EzeG99/IHP130nm---Pipeline-ADC/report/plotsBKP/WAVE_SS_sch.jpg

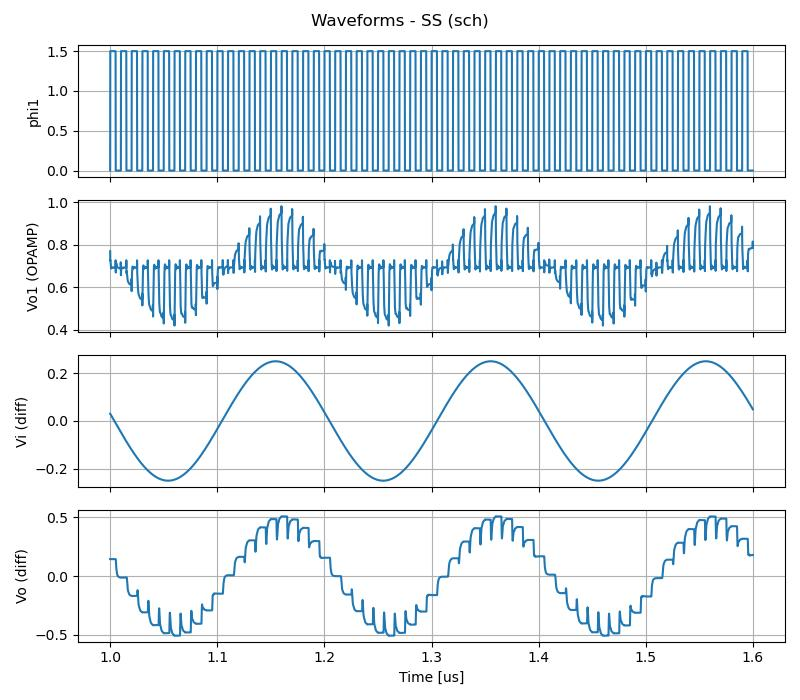
report/plotsBKP/WAVE_SS_sch.jpg
