EzeG99/IHP130nm---Pipeline-ADC/report/main.tex

\documentclass[11pt,a4paper]{article}
% ===============================
% Packages
% ===============================
\usepackage[margin=2.5cm]{geometry}
\usepackage{graphicx}
\usepackage{caption}
\usepackage{amsmath}
\usepackage{svg}
\usepackage{siunitx}
\usepackage{booktabs}
\usepackage{float}
\usepackage{cite}
\usepackage{hyperref}
\usepackage{amsmath}
\usepackage{amssymb}
\usepackage{subcaption}
\usepackage{tikz}
\usepackage{tikz-cd}
\usepackage{float}
\usepackage{multicol}
\usepackage{threeparttable}
\usepackage{threeparttable}
\usepackage{cite}

% ===============================
% Title
% ===============================
\title{Design Methodology of a Multiplying DAC for a 10-bit, 100~MS/s Pipeline ADC in IHP 130~nm CMOS}
\author{Giorgis Ezequiel}
\date{\today}

\begin{document}

\begin{titlepage}
    \centering
    \vspace*{\fill}

    {\Huge Design Methodology of a Multiplying DAC for a 10-bit, 100~MS/s Pipeline ADC in IHP 130~nm CMOS \par}
    \vspace{1.5cm}

    {\huge Giorgis Ezequiel \par}
    \vspace{0.5cm}

    {\Large \today \par}

    \vspace*{\fill}
\end{titlepage}
\tableofcontents
\newpage

% =========================================================
\begin{abstract}
This work presents the complete design flow of a MDAC stage for a 10 bits, 100 M/s
ADC implemented in IHP 130~nm CMOS usign open source tools. 
The target converter operates at 1.5V, 100~MS/s with 10-bit resolution and 1V$_{pp}$ 
differential output swing, with robust operation across process, voltage, and temperature (PVT) corners.
Starting from system-level requirements, we derive 
quantitative MDAC constraints on thermal noise, closed-loop settling, static gain 
accuracy, slew-rate, unity-gain bandwidth (UGBW), and phase margin for a given capacitive load.
\end{abstract}

\section{Introduction}
Pipeline Analog-to-Digital Converters (ADCs) are in modern high-speed, medium-to-high resolution 
applications due to their favorable trade-off between sampling rate, power efficiency, and achievable accuracy.

\begin{figure}[H]
  \begin{center}
    
  \end{center}
  \caption{Block diagram of a ADC pipeline}\label{fig:block}
\end{figure}

As described in \cite{razavi_data_converters}, this type of ADCs achieve high throughput by distributing quantization across 
multiple stages as shown in Fig. \ref{fig:block}, each composed of a sub-ADC, sub-DAC, residue amplifier, and 
sample-and-hold function. The MDAC (Fig. \ref{fig:mdac}) is the central block in each stage because 
it both reconstructs the coarse quantization level and amplifies the residue for the 
next stage. For an ideal 1.5-bit/stage implementation, the residue transfer is
\begin{equation}
V_{res}=2V_{in}-D\cdot V_{ref},
\end{equation}
where $D\in\{-1,0,+1\}$ is the digital decision and the gain factor of 2 is realized by capacitor ratio and closed-loop OTA action.

\begin{figure}[H]
  \begin{center}
    
  \end{center}
  \caption{Flip around MDAC}\label{fig:mdac}
\end{figure}

\section{System-Level Specifications and Derived MDAC Targets}
\subsection{ADC specifications}
The intended converter parameters are summarized in Table~\ref{tab:spec}, while operating conditions are outlined in Table \ref{tab:conditions}.

\begin{table}[h]
\centering
\caption{System specifications}
\label{tab:spec}
\begin{tabular}{lc}
\hline
\textbf{Parameter} & \textbf{Target} \\
\hline
Architecture & Pipeline \\
Structure & Fully differential \\
Resolution & 10 bits \\
Sampling rate $f_s$ & 100~MS/s \\
Output swing & 1V$_{pp}$ differential \\
Technology & IHP 130~nm CMOS \\
\hline
\end{tabular}
\end{table}

\begin{table}[h]
\centering
\caption{System operating conditions}
\label{tab:conditions}
\begin{tabular}{lc}
\hline
\textbf{Condition} & \textbf{Value} \\
\hline
Load capacitance $C_L$ & 1.25~pF \\
Supply voltage $V_{DD}$ & 1.5~V \\
Common-mode level $V_{CM}$ & 0.7~V \\
Operating temperature  & $0^\circ C$ to  $125^\circ C$\\
\hline
\end{tabular}
\end{table}
\subsection{Derived amplifier requirements}
\subsubsection{Gain}
For a closed-loop residue gain of 2, finite OTA gain $A_0$ introduces fractional gain error roughly
\begin{equation}
\varepsilon_g\approx\frac{1}{\beta A_0},
\end{equation}
where $\beta$ is the feedback factor (typically near 0.5 in a gain-of-2 MDAC). Requiring residue gain error to be significantly below 0.5 LSB referred to full scale leads to
\begin{equation}
\varepsilon_g\lesssim\frac{1}{2^{N+1}} \quad\therefore\quad A_0\gtrsim\frac{2^{N+1}}{\beta}.
\end{equation}
For $N=10$ and $\beta=0.5$, this implies $A_0\gtrsim 4096$ ($\approx72$~dB). With digital calibration and redundancy, relaxed targets are possible; nevertheless 70--75~dB open-loop gain is a robust design objective.

\subsubsection{Unity-Gain Bandwidth and Phase Margin}
At 100~MS/s, the clock period is 10~ns. With two non-overlapping phases, available settling time in amplification phase is approximately
\begin{equation}
T_{\phi2,eff}\approx 4\text{--}5\;\text{ns}
\end{equation}
after subtracting switch dead-time and comparator latching overhead.

For first-order settling,
\begin{equation}
\left|\varepsilon_{dyn}\right|\approx e^{-t/\tau},\qquad \tau\approx\frac{1}{2\pi\beta\,\text{UGBW}}.
\end{equation}
Imposing $\varepsilon_{dyn}<1/2^{N+1}$ at $t=T_{\phi2,eff}$ yields
\begin{equation}
\text{UGBW}\gtrsim \frac{\ln(2^{N+1})}{2\pi\beta T_{\phi2,eff}}.
\end{equation}
For $N=10$, $\beta=0.5$, and $T_{\phi2,eff}=4.5$~ns, UGBW is around 540~MHz.

\subsubsection{Thermal Noise and Sampling Capacitor}
According to \cite{kledrowetz_mdac_2011}, the thermal noise introduced by the sampling switch is shaped by the RC network formed by the switch resistance $R$ and the sampling capacitor $C_s$, which behaves as a first-order low-pass filter with transfer function:

\begin{equation}
A(j\omega) = \frac{1}{1 + j\omega R C_s}
\end{equation}

The total sampled noise is obtained by integrating the filtered noise power spectral density over frequency:

\begin{equation}
\overline{e_n^2} = \frac{1}{2\pi} \int_{0}^{\infty} \overline{e_R^2} \cdot |A(j\omega)|^2 \, d\omega
\end{equation}

Substituting the thermal noise of the resistor:

\begin{equation}
\overline{e_R^2} = 4kTR
\end{equation}

\begin{align}
  \overline{e_n^2} &= \frac{1}{2\pi} \int_{0}^{\infty} \frac{4kTR}{1 + (\omega R C_s)^2} \, d\omega \\
\overline{e_n^2} &= \frac{1}{2\pi} \cdot \frac{4kTR}{R C_s} \cdot \left[ \arctan(\omega R C_s) \right]_{0}^{\infty} = \frac{kT}{C_s}
\end{align}

Imposing the resolution constraint:

\begin{equation}
\sigma_n \le \frac{LSB}{2}, \quad LSB = \frac{V_{FS}}{2^N} \Rightarrow C_s \ge \frac{kT}{(LSB/2)^2}
\end{equation}

In practice:

\begin{equation}
C_s \approx \alpha \cdot \frac{kT}{(LSB/2)^2}, \quad \alpha \approx 3\text{--}10
\end{equation}
\subsubsection{Requirements summary}
\begin{table}[H]
\centering
\caption{Target OTA specifications}
\label{tab:spec_OTA}
\begin{tabular}{lc}
\hline
\textbf{Parameter} & \textbf{Target} \\
\hline
Gain $A_0$ & $\ge$ 70~dB \\
Unity-Gain Bandwidth UGBW & $\ge$ 540~MHz \\
Phase Marigin PM & $\ge$ 60$^\circ$ \\
Output swing & 1~V$_{pp}$ diff. \\
ENOB @ $f_{in} \approx f_{s}/20$ & $\ge 9.5$ bits \\
ENOB @ $f_{in} \approx f_{s}/2$ & $\ge 8$ bits \\
Sampling capacitors   & $\approx 500$ fF \\
Load capacitance $C_L$ & 1.25~pF \\
Supply voltage $V_{DD}$ & 1.5~V$\pm$5\% \\
Common-mode level $V_{CM}$ & 0.7~V$\pm$5\% \\
Bias current $I_{ref}$ & 50~$\mu$A$\pm$5\% \\
Operating temperature  & $0^\circ C$ to  $125^\circ C$ \\
\hline
\end{tabular}
\end{table}

\subsection{Corners definition}
To ensure the MDAC meets gain, settling, and stability targets under realistic spread, corner-based verification is grouped into three principal process conditions: slow-slow (SS), typical-typical (TT), and fast-fast (FF). Each process corner is evaluated together with coordinated perturbations of supply/common-mode voltages and OTA bias current, all with $\pm 5\%$ variation around nominal values.
\begin{table}[h]
\centering
\caption{Corner grouping with process and $\pm 5\%$ bias/supply variations}
\label{tab:corner_grouping}
\begin{tabular}{cccccc}
\hline
\textbf{Group} & \textbf{Process corner} & \textbf{$VDD$} & \textbf{$V_{CM}$} &\textbf{$I_{bias}$} &Temperature \\
\hline
SS group & SS & $1.425$~V &$0.665$~V & $47.5~\mu$A &$125^\circ C$\\
TT group & TT & $1.500$~V &$0.7$~V & $50.0~\mu$A &$65^\circ C$\\
FF group & FF & $1.575$~V &$0.735$~V & $52.5~\mu$A &$0^\circ C$\\
\hline
\end{tabular}
\end{table}

Future work will extend this approach to a full cartesian combination of these variables to ensure comprehensive coverage of all possible operating conditions.

\section{Amplifier design}
\subsection{Topology Selection}
A folded cascode OTA with PMOS input pair (Fig. \ref{fig:FoldedCascode}) is selected to maximize input common-mode range and reduce flicker noise. The PMOS input devices allow operation with input voltages close to ground, which is suitable for switched-capacitor MDAC environments. The folded structure provides high gain while maintaining moderate voltage headroom under low supply conditions.

The signal path consists of a PMOS differential pair with transconductance $g_{m1}$, whose currents are folded into NMOS cascode devices, producing a high output resistance node.
\begin{figure}[H]
  \begin{center}
    
  \end{center}
  \caption{Main folded cascode amplifier}\label{fig:FoldedCascode}
\end{figure}

\subsection{Gain}
For a folded-cascode stage, low-frequency gain can be approximated as
\begin{equation}
A_0 \approx g_{m1}R_{out},
\end{equation}
where $R_{out}$ is the small-signal resistance at the output node. With cascoding,
\begin{equation}
  R_{out} \approx \left(g_{m7,8}r_{O7,8}r_{O9,10}\right) \parallel \left[g_{m3,4}r_{O3,4}(r_{O5,6}\parallel r_{O1,2})\right]
\end{equation}
Hence, gain is increased primarily by: (i) maximizing $g_{m1}$ — wich also increase bandwidth — and (ii) increasing $r_O$ through longer channel devices.

\subsection{Gain enhancement}
To meet gain under 130~nm intrinsic gain limits, gain enhancement (gain-boosting) is applied to NMOS cascode transistors. If auxiliary amplifiers provide local gain $A_1$, then effective output resistance scales approximately as
\begin{equation}
R_{out,eff} \approx R_{out}\,(1+A_1),
\end{equation}
Practical implementation must preserve stability; therefore gain-boosting amplifier poles should be placed sufficiently above MDAC closed-loop bandwidth, or compensated to avoid excess phase lag near unity crossover.

\begin{figure}[H]
  \begin{center}
    
  \end{center}
  \caption{Auxiliary gain enchancement folded cascode amplifier}\label{fig:gmBoosting}
\end{figure}

The auxiliary amplifier itself (Fig. \ref{fig:gmBoosting}) is implemented using a folded cascode topology, which provides high gain. Because the ouput swing is relative small, to stabilize its output common-mode voltage, a continuous-time common-mode feedback (CMFB) network based on MOS transistors operating in the triode region is employed. These devices act as voltage-controlled resistors, setting the output common-mode level without introducing significant additional poles.
\subsection{Frequency response}
The frequency response of the folded cascode OTA is analyzed using the node-pole association method, which allows identifying the dominant poles by associating each high-impedance node with its corresponding resistance and capacitance. Neglecting gain boosting effects, the response is dominated by three main nodes: the output node, the internal folding node $X$ (noted in Fig. \ref{fig:FoldedCascode}), and the input node.

The dominant pole is typically located at the output due to the large load capacitance $C_L$ and high output resistance $R_{out}$:

\begin{equation}
\omega_{p,out} \approx \frac{1}{R_{out} C_L}
\end{equation}

The internal node $X$, corresponding to the folded branch (drain of the input pair and source of the cascode devices), introduces a non-dominant pole given by:

\begin{equation}
\omega_{p,X} \approx \frac{1}{R_X C_X}
\end{equation}

with:

\begin{equation}
  R_X \approx \frac{1}{g_{m3,4}}, \quad C_X \approx C_{gs3,4} + C_{sb3,4} + 2C_{gd5,6} + C_{db5,6}
\end{equation}

Stability requires sufficient separation between $\omega_{p,out}$ and the higher-frequency poles at node $X$ and the input, indicating the need of a high $g_{m3,4}$ to ensure a phase margin greater than $60^\circ$.

At the input, the pole is defined by the source resistance and the total input capacitance:

\begin{equation}
\omega_{p,in} \approx \frac{1}{R_{in} C_{in}}
\end{equation}

where:

\begin{equation}
C_{in} \approx C_{gs1} + C_{gd1}(1 + A_v)
\end{equation}

The Miller multiplication of $C_{gd1}$ can significantly increase the effective input capacitance, although in switched-capacitor applications this effect is partially mitigated by the sampling network.

Overall, the unity-gain bandwidth is primarily determined by:

\begin{equation}
UGBW \approx \frac{g_{m1,2}}{C_L}
\end{equation}
To reach a UGBW of 540~MHz for a load of $C_L=1.25$ pF, the $g_{m1,2}$ will be
\begin{equation}
  g_{m1,2} = 2\pi 540\,\text{MHz} \times 1.25\,\text{pF} = 4.2\,\text{mS} \\
\end{equation}
Considering a $g_m/I_{D}=15$
\begin{equation}
  I_{D_{M1,2}} = \frac{4.2\text{mS}}{15} \approx 280\,\text{$\mu$A} \,\therefore\, I_{D_{M0}} \approx 560\text{$\mu$ A}
\end{equation}

\subsection{Sizing}
\begin{table}[h]
\centering
\caption{Main folded cascode (Fig. \ref{fig:FoldedCascode}) transistor sizing}
\begin{tabular}{c c c c}
\hline
\textbf{Transistor} & \textbf{W/L [$\mu$m]} & \textbf{Fingers} & \textbf{Multiplier} \\
\hline
$M_0$            & 113.5/0.3 &210 &8 \\
$M_1, M_2$       & 115/0.13  &100 &2 \\
$M_3, M_4$       & 44.4/0.3  &22  &6 \\
$M_5, M_6$       & 24.3/0.8  &62  &6 \\
$M_7, M_8$       & 100/0.4   &150 &4 \\
$M_9, M_{10}$    & 63.2/0.8  &103 &4 \\
\hline
\end{tabular}
\end{table}

\begin{table}[h]
\centering
\caption{Auxiliary gain enchancement folded cascode (Fig. \ref{fig:gmBoosting}) transistor sizing}
\begin{tabular}{c c c c}
\hline
\textbf{Transistor} & \textbf{W/L [$\mu$m]} & \textbf{Fingers} & \textbf{Multiplier} \\
\hline
$M_0, M_{14}$            &12/0.3     &12  &1   \\
$M_1, M_2$               &35/0.15    &70  &4   \\
$M_3, M_4$               &38.7/0.6   &5   &1   \\
$M_5, M_6$               &20.2/0.7   &5   &2   \\
$M_7, M_8$               &23.2/0.3   &10  &1   \\
$M_9, M_{10}$            &19.8/0.7   &20  &2   \\
$M_{11}, M_{12}, M_{15}$ &20/0.3     &5   &1   \\
$M_{13}$                 &32/0.7     &4   &1   \\
\hline\end{tabular}
\end{table}

\subsection{Bias Network}
Within the bias network, a low-voltage (wide-swing) cascode current mirror (Fig. \ref{fig:bias}) is adopted to 
generate stable bias currents while preserving voltage headroom under the 1.5 V supply 
constraint. Conventional cascode mirrors are unsuitable in this context because 
they impose an excessive minimum output voltage, on the order 
of $(V_{GS0}-V_{TH})+(V_{GS1}-V_{TH})+V_{TH}$, thereby limiting the allowable 
signal swing in critical high-impedance nodes of the folded-cascode OTA. To overcome 
this limitation, the implemented topology enforces $V_{DS}$ matching between 
reference and output devices ($V_{DS1} \approx V_{DS2}$), biasing both transistors 
at the edge of saturation ($V_{DS} \approx V_{GS}-V_{TH}$). This condition is 
achieved through a carefully generated cascode gate bias $V_b=V_{GS3}+(V_{GS2}-V_{TH})$,
ensuring all devices remain in saturation while minimizing headroom consumption. 
As a result, the minimum required output voltage is reduced to approximately $2V_{D,\text{sat}}$, 

\begin{figure}[H]
  \begin{center}
    
  \end{center}
  \caption{Bias network}\label{fig:bias}
\end{figure}

\subsection{Switched capacitor common mode feedback}
The switched-capacitor common-mode feedback (SC-CMFB) circuit regulates the output common-mode voltage by periodically sensing and correcting it through charge redistribution (Fig. \ref{fig:cmfb}). During phase $\phi_1$, the sampling capacitors acquire the output common-mode level:

\begin{equation}
V_{CM,out} = \frac{V_{O1} + V_{O2}}{2}
\end{equation}

In phase $\phi_2$, the capacitors are reconnected to the reference common-mode voltage $V_{CM,ideal}$, generating an error proportional to:

\begin{equation}
\Delta V_{CM} = V_{CM,out} - V_{CM,ideal}
\end{equation}

This error is transferred to the control node $V_{CMFB}$, which adjusts the OTA biasing (e.g., $M_{5,6}$ gate voltage), closing the feedback loop and forcing: $V_{CM,out} \rightarrow V_{CM,ideal}$

The switched-capacitor implementation ensures accurate common-mode sensing and is inherently compatible with discrete-time operation. Proper capacitor matching and non-overlapping clock phases are required to minimize offset, charge injection, and instability in the CMFB loop.

All four capacitors of the SC-CFMB were implemented in MIM technology.
\begin{table}[h]
  \centering
  \caption{SC-CMFB (Fig. \ref{fig:FoldedCascode}) capacitor sizing}
  \begin{tabular}{ccc}
    \hline
    \textbf{Capacitor} & \textbf{W/L [$\mu$m]} & \textbf{Value [fF]} \\
    \hline
    $C_1,C_2$            & 10/10 &151.6 \\
    $C_3,C_4$            & 4.5/4.5 &31.1 \\
    \hline
  \end{tabular}
\end{table}

\begin{figure}[H]
  \begin{center}
    
  \end{center}
  \caption{SC-CMFB circuit}\label{fig:cmfb}
\end{figure}

\subsection{Boostrapped Switch and Transmission Gates}
Switch linearity and switching noise are critical in SC-MDAC accuracy. Based on the provided bootstrap topology, two switch classes are used in this design: (i) bootstrapped NMOS switches for high-linearity signal sampling paths (Fig. \ref{fig:sw}), and (ii) transmission gates in auxiliary/feedback paths where reduced charge-injection noise and robust rail-to-rail conduction are preferred.

In the bootstraped switches a capacitor is precharged (denoted $C_B$ in the schematic) and, during the ON phase, drives the sampling-switch gate so that
$V_{GS,switch} \approx V_{DD}$ and, therefore,
approximately independent of input common-mode and instantaneous signal value. Consequently, the ON resistance
\begin{equation}
R_{on} \approx \frac{1}{\mu_n C_{ox}(W/L)(V_{GS}-V_{TH})}
\end{equation}
becomes much less signal-dependent than with a simple NMOS gate drive. This strongly reduces harmonic distortion and gain error due to sampling-time RC variation. The design of this class of switches was carried out following the methodology described in \cite{razavi_bootstrap_2021}

\begin{figure}[H]
  \begin{center}
    
  \end{center}
  \caption{Boostrapped switch circuit}\label{fig:sw}
\end{figure}

A transmission gate (parallel NMOS+PMOS driven by complementary clocks) provides bidirectional conduction with lower effective charge-injection asymmetry than a single MOS switch. Its equivalent ON resistance is
\begin{equation}
R_{on,TG} \approx (R_{on,n} \parallel R_{on,p}).
\end{equation}

In this design, transmission gates are intentionally used at nodes where the priority is to reduce switching-noise feedthrough and clock-induced disturbance rather than maximize absolute linearity; specifically, they are used in the CMFB switching network.

\section{Simulations results}
\subsection{Open Loop}
The open-loop performance of the designed OTA is evaluated through a dedicated testbench (Fig. \ref{fig:OL_TB}) 
consisting of an AC simulation. Because the SC-CMFB is not included here, the $V_{CMFB}$ is manually 
set to a voltage that produce the desire $V_{\text{CM, out}}$. Others approaches may be considered in future work.

The results include gain and phase responses across the considered corners (Fig. \ref{fig:OL}) as well as measured values of interest in Table \ref{tab:OL_values}.
\begin{figure}[H]
  \begin{center}
    
  \end{center}
  \caption{Open Loop Testbench}\label{fig:OL_TB}
\end{figure}

\begin{figure}[H]
\centering
    \begin{subfigure}[b]{0.495\textwidth}
    \centering
    
    \caption{}\label{fig:OL_gain}
    \end{subfigure}
    \begin{subfigure}[b]{0.495\textwidth}
    \centering
    
    \caption{}\label{fig:OL_phase}
    \end{subfigure}
\caption{Open loop AC performance of a) gain and b) phase}
\label{fig:OL}
\end{figure}

\begin{table}[H]
\centering
\caption{Performance summary across corners}\label{tab:OL_values}
\begin{tabular}{llccc}
\hline
\textbf{Metric} &\textbf{Target} & \textbf{TT} & \textbf{SS} & \textbf{FF} \\
\hline
Gain [dB]     &$\ge$ 70 dB  & 72.61 &72.27 &72.41 \\
UGBW [MHz]    &$\ge$ 540 MHz & 636.5 &571.53 &802.65 \\
PM [$^\circ$] &$\ge$ 60$^\circ$ & 64.16 &60.12 &62.30 \\
\hline
\end{tabular}
\end{table}

%\subsubsection{Input common mode range}
%The input common-mode range (ICMR) is evaluated by sweeping the input common-mode voltage and observing both the output voltage and the amplifier gain.
%\begin{figure}[H]
%  \begin{center}
%    \includegraphics[width=0.6\textwidth]{../sch/AutoTestbench/post/plots/ICMR_combined.pdf}
%  \end{center}
%  \caption{}\label{fig:ICMR_combined}
%\end{figure}

\subsection{Close Loop and FFT}
Closed-loop transient and spectral simulations are performed to evaluate the MDAC behavior under 
realistic operating conditions. This was archived through the testbench show in Fig. \ref{fig:closeloop}. 
The time-domain waveforms in Fig. \ref{fig:CL_wave} demonstrate correct residue amplification and settling within the available clock phase, confirming functional operation of the switched-capacitor network and OTA.

\begin{figure}[H]
  \begin{center}
    
  \end{center}
  \caption{Close Loop Testbench}\label{fig:closeloop}
\end{figure}

The FFT analysis in Fig. \ref{fig:CL_FFT} shows that the system achieves an SNDR of approximately 64.8 dB and an ENOB above 10 bits in the typical corner. These results indicate that the MDAC meets the dynamic performance requirements for the target 10-bit ADC.

\begin{table}[H]
  \centering
  \caption{Performance summary across corners at $f_{in}=4.98046875$ MHz}
  \begin{tabular}{lccc}
    \hline
    \textbf{Metric} & \textbf{TT} & \textbf{SS} & \textbf{FF} \\
    \hline
    SNR [dB]   & 74.70 &74.84   &72.66 \\
    SNDR [dB]  & 64.12 &61.57   &65.96 \\
    THD [dB]   & -64.52 &-61.78 &-67.00 \\
    SFDR [dB]  & 66.33 &63.71   &70.26 \\
    ENOB [bits]& 10.36 &9.93    &10.66 \\
    \hline
  \end{tabular}
\end{table}

\begin{table}[H]
  \centering
  \caption{Performance summary across corners at $f_{in}=43.26171875$ MHz}
  \begin{tabular}{lccc}
    \hline
    \textbf{Metric} & \textbf{TT} & \textbf{SS} & \textbf{FF} \\
    \hline
    SNR [dB]    &72.87   &69.28  &72.41  \\
    SNDR [dB]   &53.32   &49.68  &53.10  \\
    THD [dB]    &-53.37  &-49.73 &-53.15  \\
    SFDR [dB]   &55.72   &52.06  &55.63  \\
    ENOB [bits] &8.57    &7.96   &8.53  \\
    \hline
  \end{tabular}
\end{table}

\begin{figure}[H]
\centering
    \begin{subfigure}[b]{0.495\textwidth}
    \centering
    
    \caption{}\label{fig:CL_wave}
    \end{subfigure}
    \begin{subfigure}[b]{0.495\textwidth}
    \centering
    
    \caption{}\label{fig:CL_FFT}
    \end{subfigure}
\caption{Close loop TT performance in a) time domain and b) frequency domain}
\end{figure}

In addition to meeting the dynamic performance requirements, the proposed MDAC demonstrates a highly efficient power consumption profile (Table \ref{tab:consumption}).
Across process corners, the average power dissipation ranges from approximately 3.97 mW to 5.75 mW under a 1.5 V supply, with a nominal consumption of 4.68 mW in typical conditions. This reduced power footprint is primarily enabled by the use of a gain-boosted folded-cascode topology, which achieves the required gain and bandwidth without resorting to multi-stage amplification or excessive bias currents. Additionally, the design leverages moderate inversion operation (gm/ID optimization) and carefully sized capacitive loads to balance dynamic performance and energy efficiency. As a result, the MDAC achieves a favorable trade-off between speed, accuracy, and power.

\begin{table}[h]
\centering
\caption{Power consumption summary across corners}
\label{tab:consumption}
\begin{tabular}{lccc}
\hline
\textbf{Metric} & \textbf{TT} & \textbf{SS} & \textbf{FF} \\
\hline
VDD [V]                        &1.5  &1.425 &1.575 \\
$I_{\text{AVG}}$ [mA]          &3.12 &2.79  &3.65 \\
P$_{\text{AVG}}$ [mW]          &4.68 &3.97  &5.75 \\
\hline
\end{tabular}
\end{table}

\section{Conclusion}
This work presented a complete design methodology for a multiplying DAC (MDAC) stage targeting a 10-bit, 100 MS/s pipeline ADC in a 130 nm CMOS technology. Starting from system-level specifications, key design constraints for the residue amplifier were analytically derived, including requirements on gain, bandwidth, noise, and settling behavior. These specifications guided the implementation of a gain-boosted folded-cascode OTA optimized for low-voltage operation and high-speed performance.

The proposed design achieves an open-loop gain above 72 dB, unity-gain bandwidth exceeding 570 MHz across corners, and phase margin greater than 60°, ensuring robust closed-loop stability. Transient and spectral simulations confirm correct MDAC operation, with SNDR up to 64 dB and ENOB above 10 bits in typical conditions, meeting the target resolution. Furthermore, the design maintains consistent performance under PVT variations, validating its robustness.

Additional building blocks, including a switched-capacitor common-mode feedback network and bootstrapped switches, were integrated to ensure accurate common-mode regulation and high linearity in the sampling process. Power consumption remains within acceptable limits for the targeted application, demonstrating an efficient trade-off between speed, accuracy, and energy.

Overall, the presented MDAC fulfills the requirements of a medium-resolution, high-speed pipeline ADC and provides a solid foundation for full converter integration, including comparator design and digital calibration.
\subsection*{Future work}
The MDAC design presented here establishes the analog residue-amplification backbone of the pipeline stage. The next development steps for complete ADC realization focus on two key blocks:

(i) Comparator design. The following iteration should implement and verify a low-offset, high-speed dynamic comparator compatible with 100~MS/s operation and 1.5-bit/stage decision levels. Main tasks include kickback-noise mitigation toward the MDAC sampling nodes, metastability analysis under worst-case small-overdrive decisions, offset calibration strategy (if required), and robust operation across SS/TT/FF corners with $\pm5\%$ supply variation.

(ii) Background digital calibration. A digital background engine should be added to continuously track and correct residue gain error, capacitor mismatch effects, and slow drift due to temperature/supply/process aging. The recommended path is to define an adaptive coefficient-estimation loop that runs during normal conversion (without foreground interruption), followed by fixed-point hardware mapping, convergence verification, and stability analysis of the analog-digital interaction loop.

At system level, future work should close the loop between these blocks and the current MDAC by means of full-stage and multi-stage behavioral/transistor co-simulation, so that static linearity, SNDR/ENOB, and calibration convergence can be validated simultaneously under PVT and Monte Carlo conditions.

\bibliographystyle{IEEEtran}
\bibliography{references.bib}{}

\end{document}
