EzeG99/IHP130nm---Pipeline-ADC/report/openLoop.pdf

tb/openLoop.sch

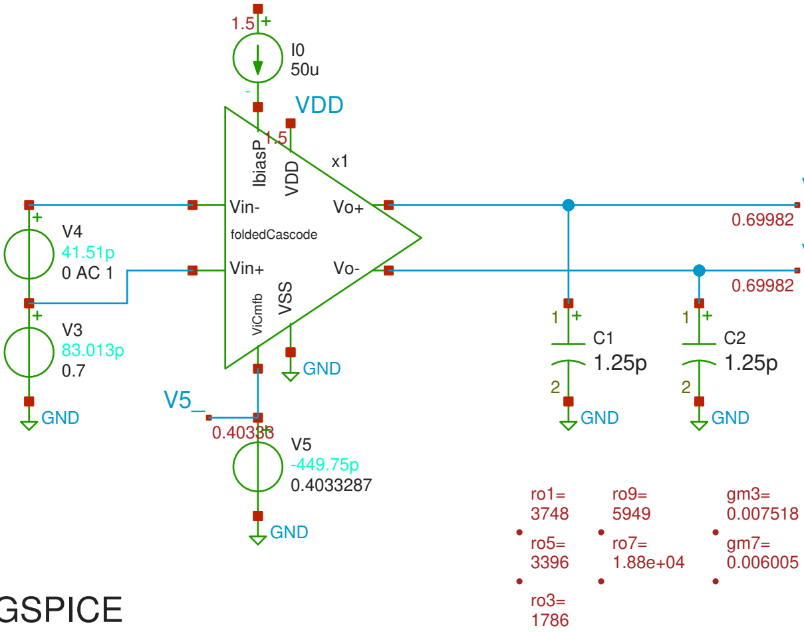
[picture p13: figure]
foldedCascode; VDD VSS; ViCmfb IbiasP; Vin-; Vin+; VDD; GND

# SimulateNGSPICE OP annotate

V1

1.5

-3.0612m

GND

## VDD

1.5

Vo1

Vo2

## Libs_Ngspice1

.lib cornerMOSlv.lib mos_tt

## SIM=ngspice

## VDD

OL
