EzeG99/IHP130nm---Pipeline-ADC/report/plotsBKP/AvOL.pdf

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

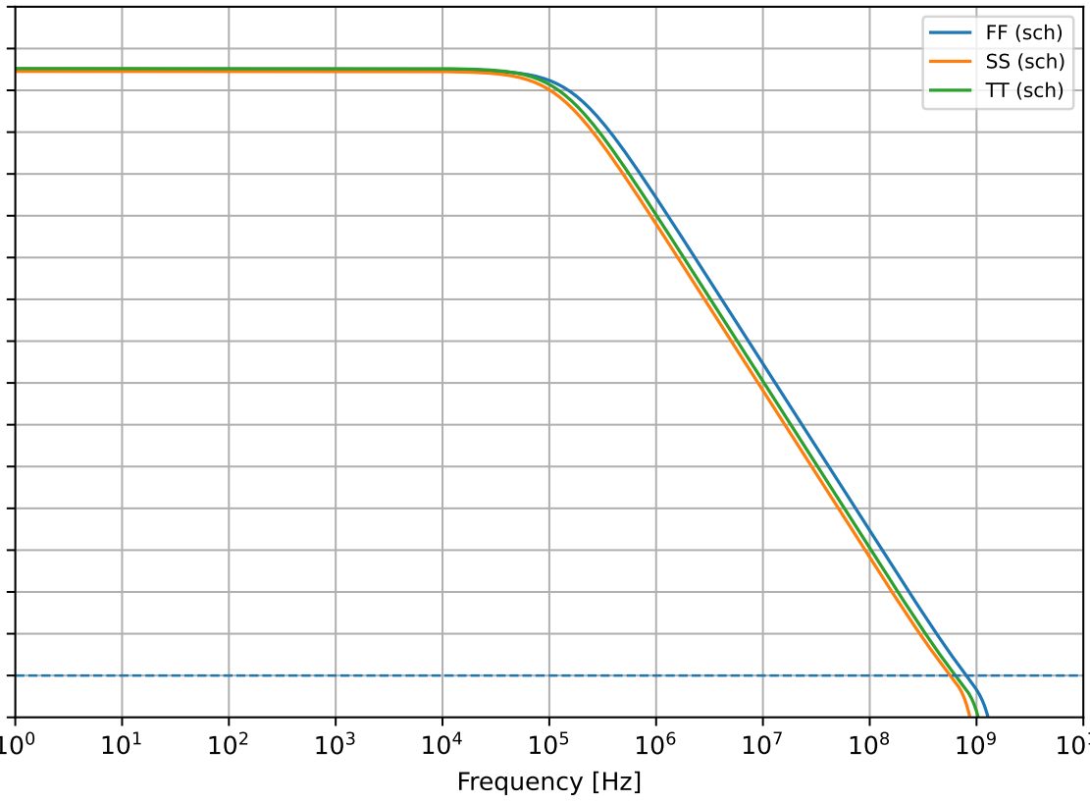
[picture p14: figure]
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
