EzeG99/IHP130nm---Pipeline-ADC/report/plotsBKP/AvOL.jpg

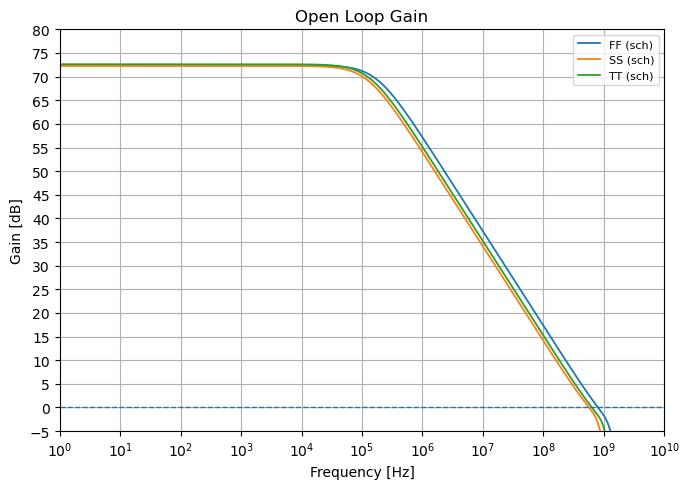
report/plotsBKP/AvOL.jpg
