EzeG99/IHP130nm---Pipeline-ADC/report/plotsBKP/FFT_FF_sch.jpg

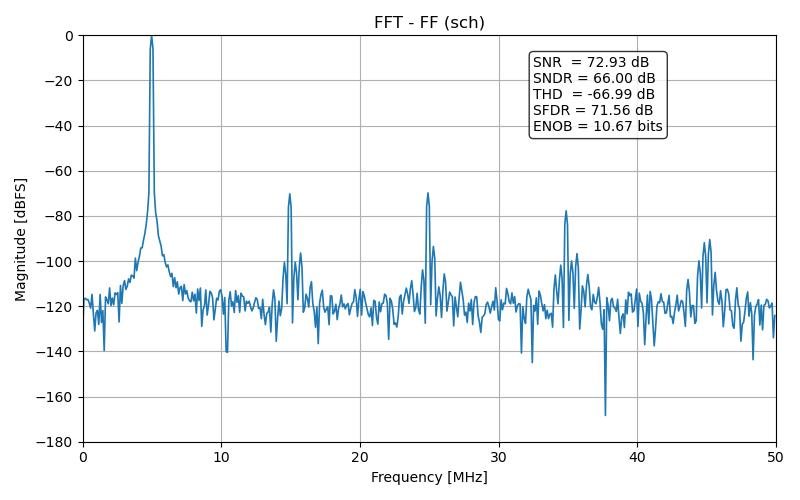
report/plotsBKP/FFT_FF_sch.jpg
