EzeG99/IHP130nm---Pipeline-ADC/report/plotsBKP/FFT_SS_sch.jpg

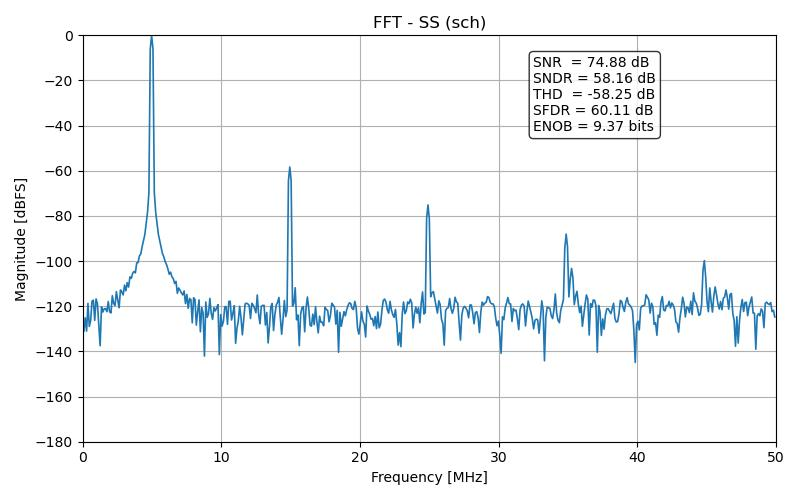
report/plotsBKP/FFT_SS_sch.jpg
