EzeG99/IHP130nm---Pipeline-ADC/report/plotsBKP/FFT_SS_VDD1.43_T125_sch.jpg

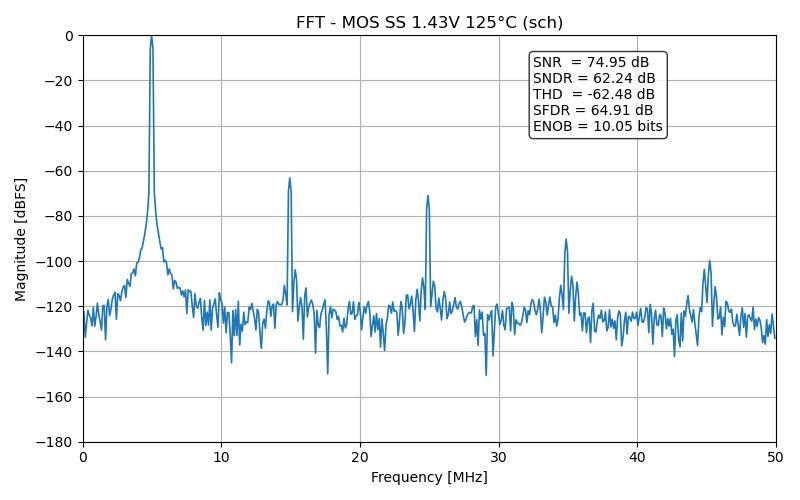
report/plotsBKP/FFT_SS_VDD1.43_T125_sch.jpg
