EzeG99/IHP130nm---Pipeline-ADC/report/plotsBKP/FFT_TT_sch.jpg

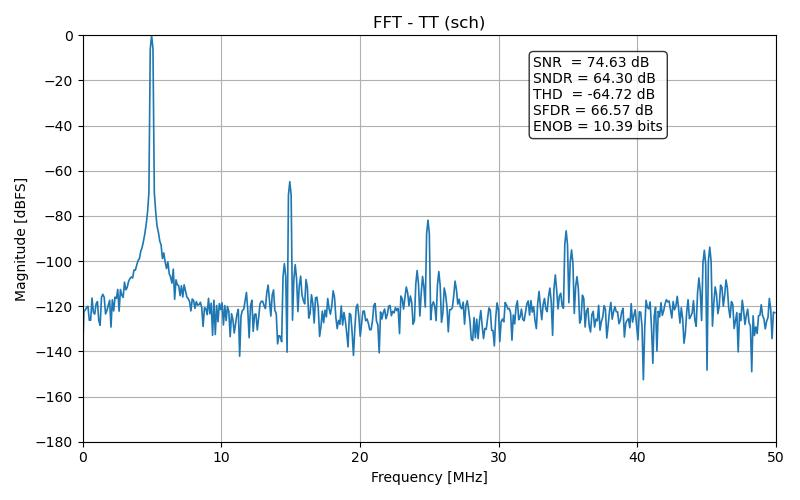
report/plotsBKP/FFT_TT_sch.jpg
