EzeG99/IHP130nm---Pipeline-ADC/report/plotsBKP/ICMR_combined.jpg

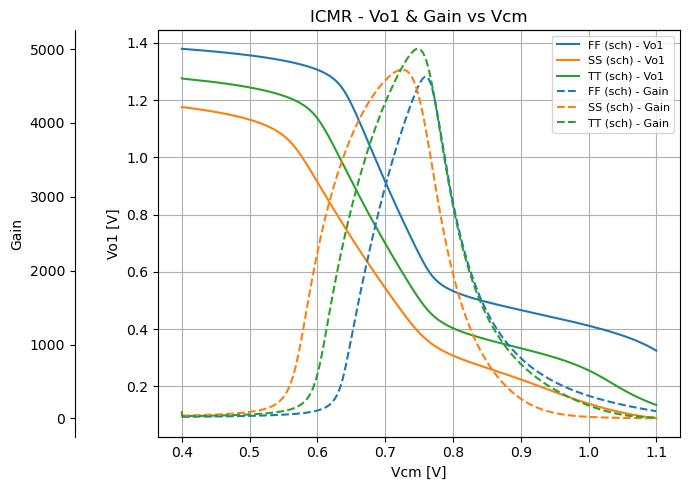
report/plotsBKP/ICMR_combined.jpg
