EzeG99/IHP130nm---Pipeline-ADC/report/plotsBKP/ICMR_Gain.jpg

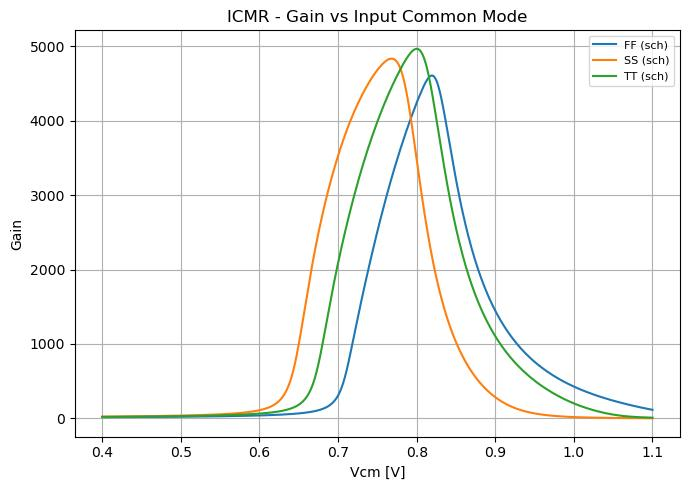
report/plotsBKP/ICMR_Gain.jpg
