EzeG99/IHP130nm---Pipeline-ADC/report/plotsBKP/ICMR_Vo1.jpg

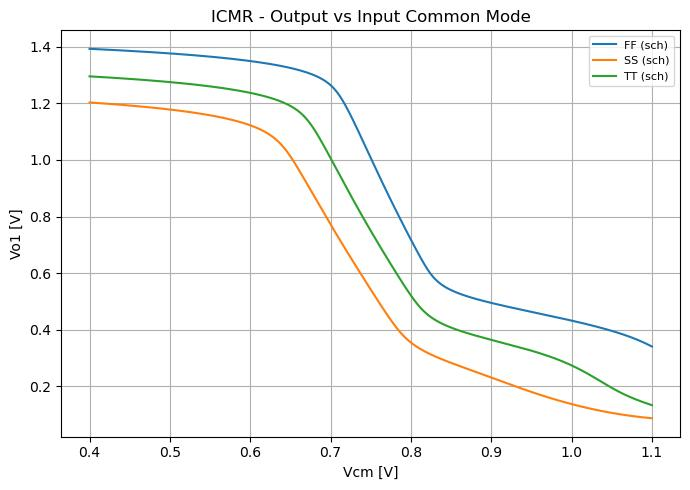
report/plotsBKP/ICMR_Vo1.jpg
