EzeG99/IHP130nm---Pipeline-ADC/report/plotsBKP/PhaseOL.jpg

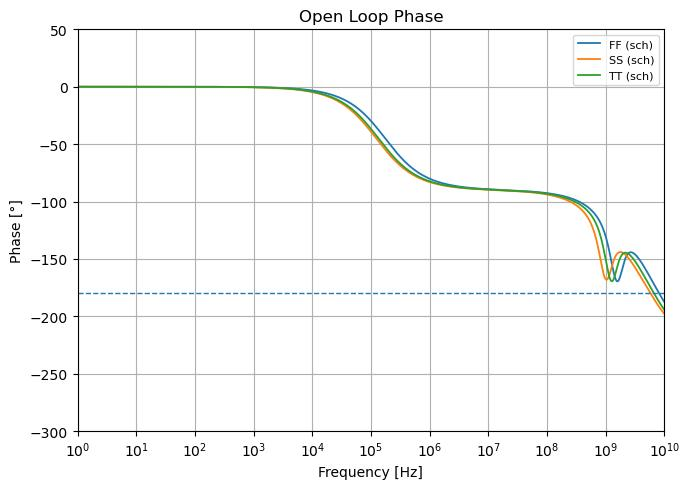
report/plotsBKP/PhaseOL.jpg
