EzeG99/IHP130nm---Pipeline-ADC/report/FoldedCascode.pdf

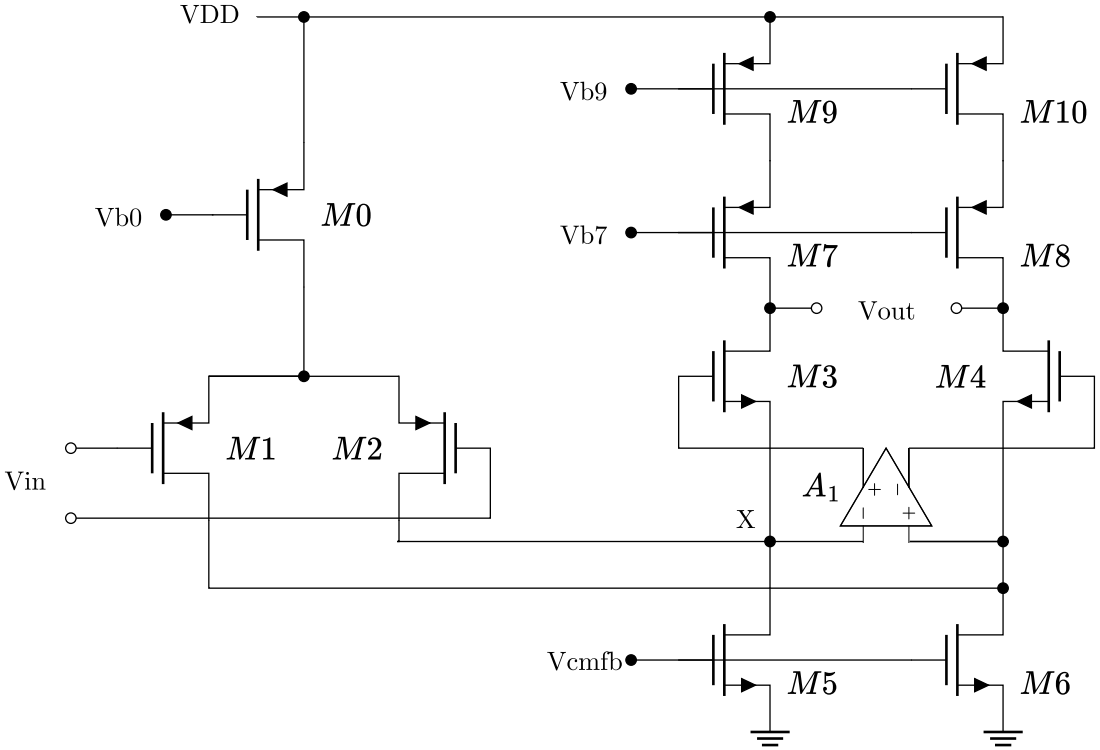
[picture p24: page 1]
