EzeG99/IHP130nm---Pipeline-ADC/report/bias.pdf

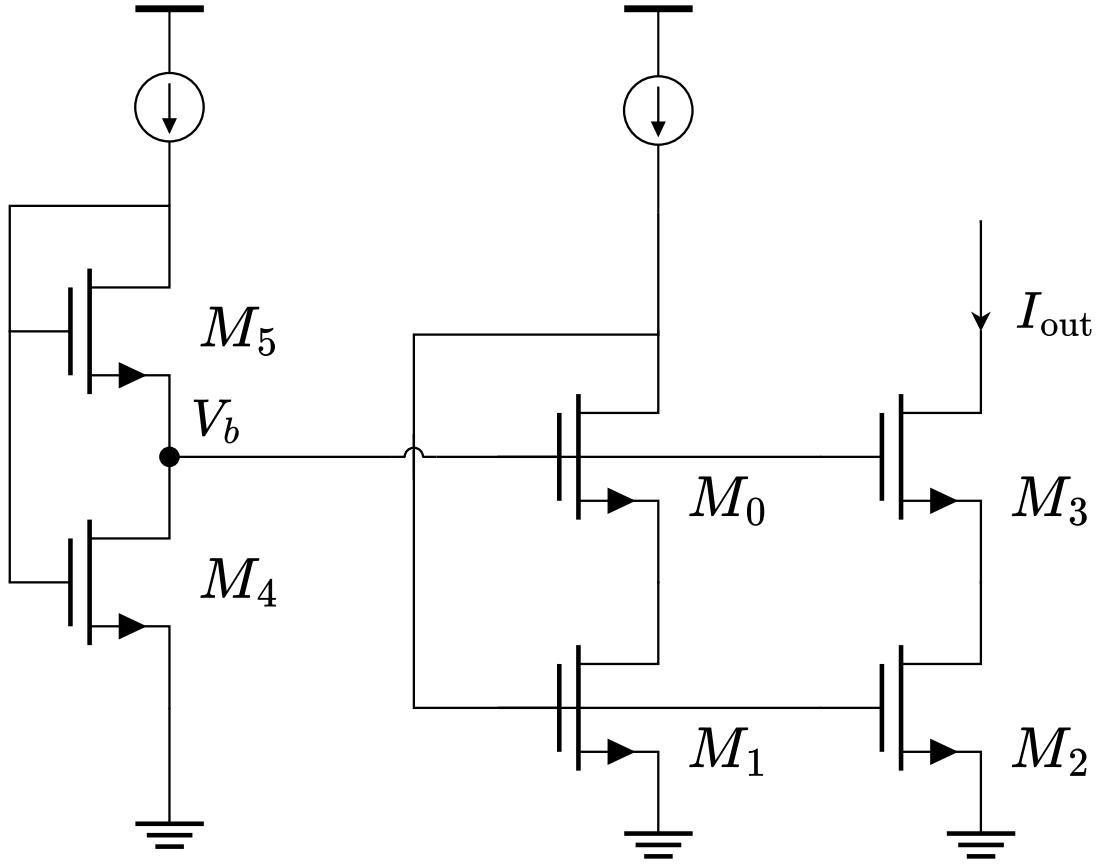
[picture p25: page 1]
