EzeG99/IHP130nm---Pipeline-ADC/report/block.pdf

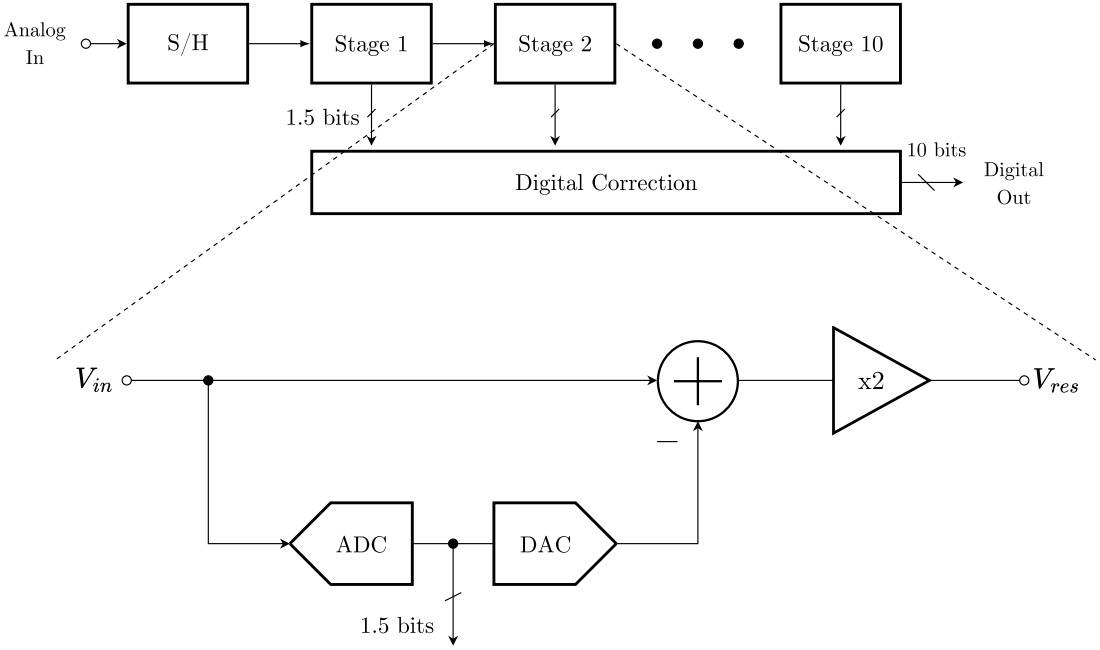
[picture p26: page 1]
