EzeG99/IHP130nm---Pipeline-ADC/report/gmBoosting.pdf

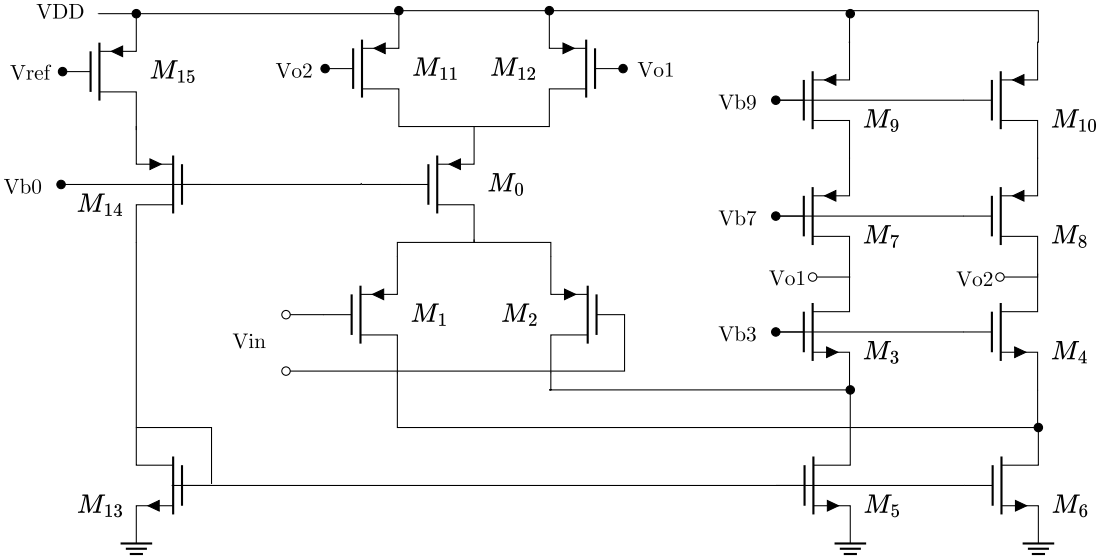
[picture p27: page 1]
