EzeG99/IHP130nm---Pipeline-ADC/report/mdac.pdf

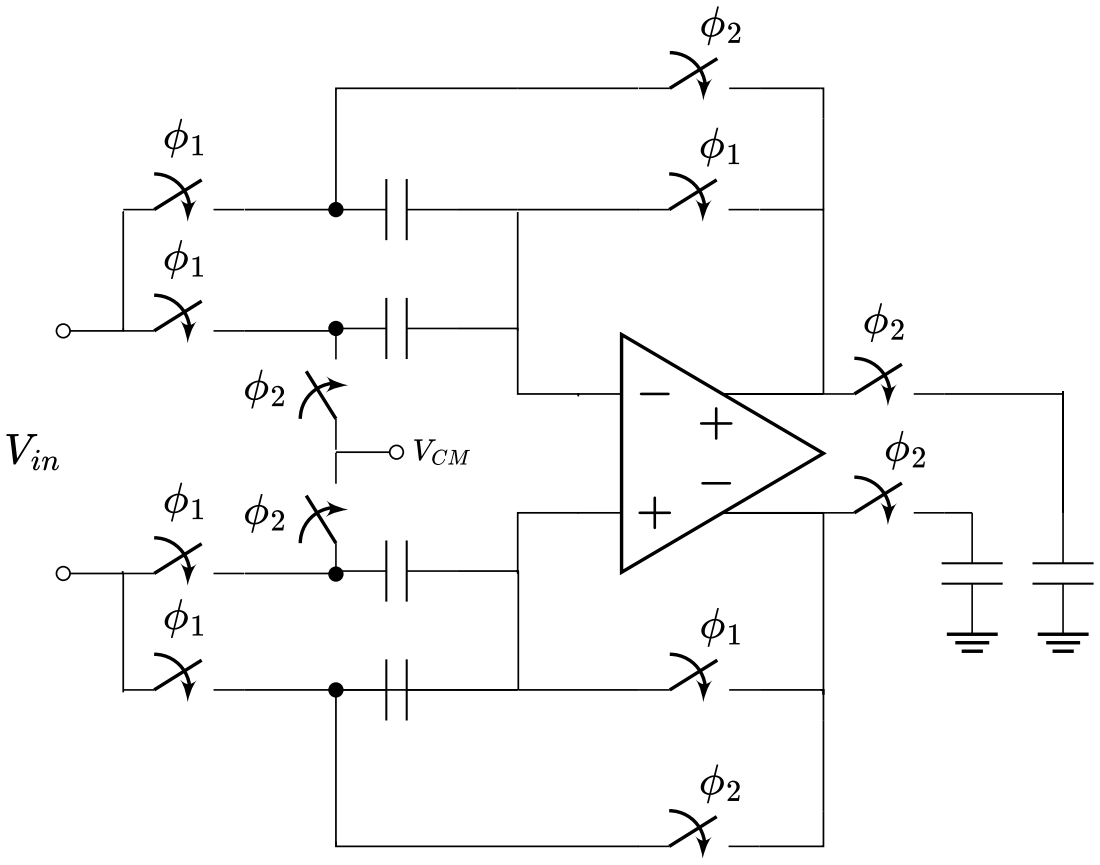
[picture p28: page 1]
