EzeG99/IHP130nm---Pipeline-ADC/report/sw.pdf

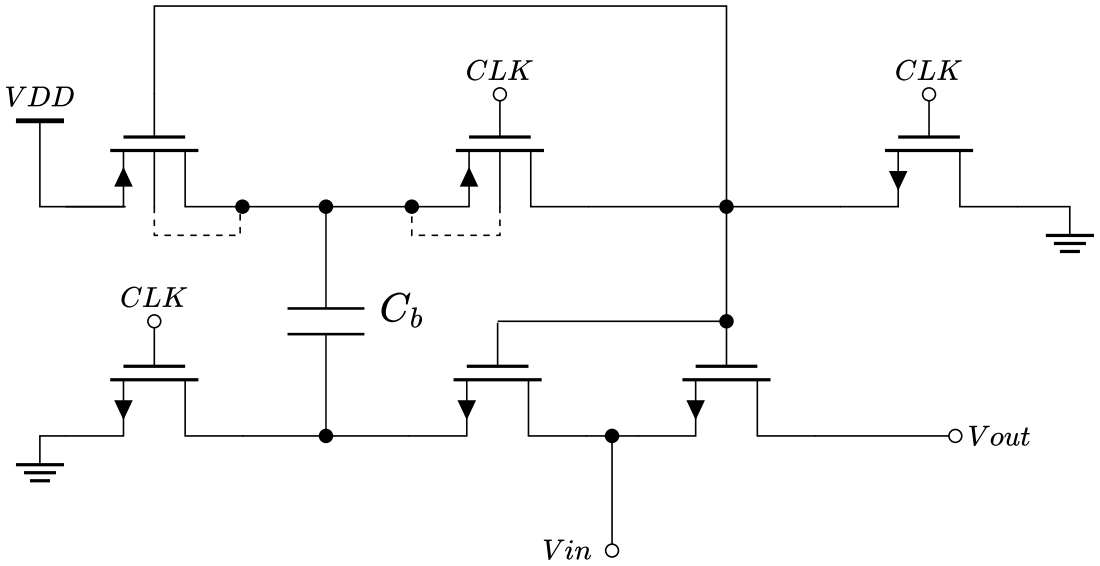
[picture p29: page 1]
