EzeG99/IHP130nm---Pipeline-ADC/report/cmfb.pdf

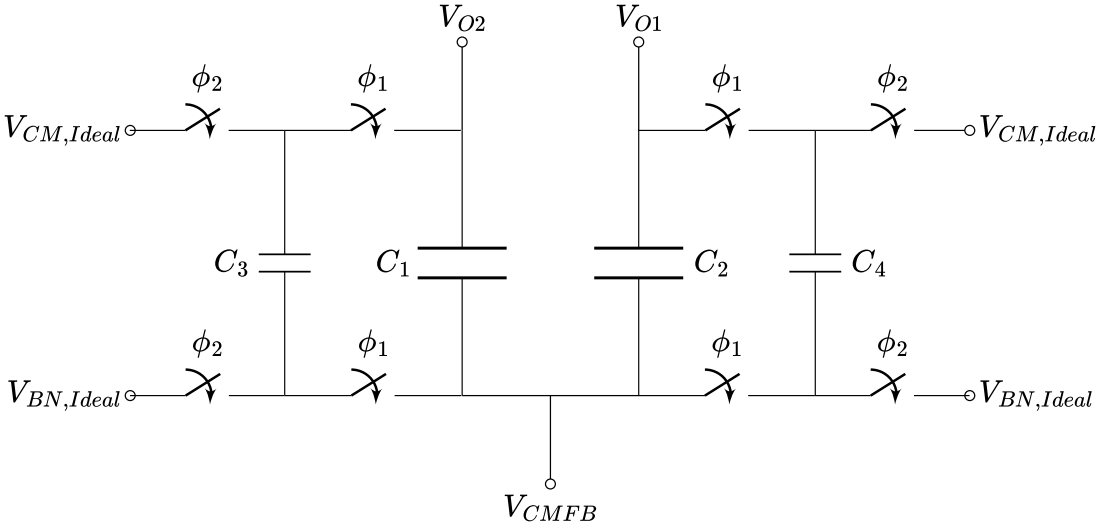
[picture p30: page 1]
