EzeG99/IHP130nm---Pipeline-ADC/report/closeLoop.pdf

# tb/closeLoop.sch

## Libs_Ngspice1

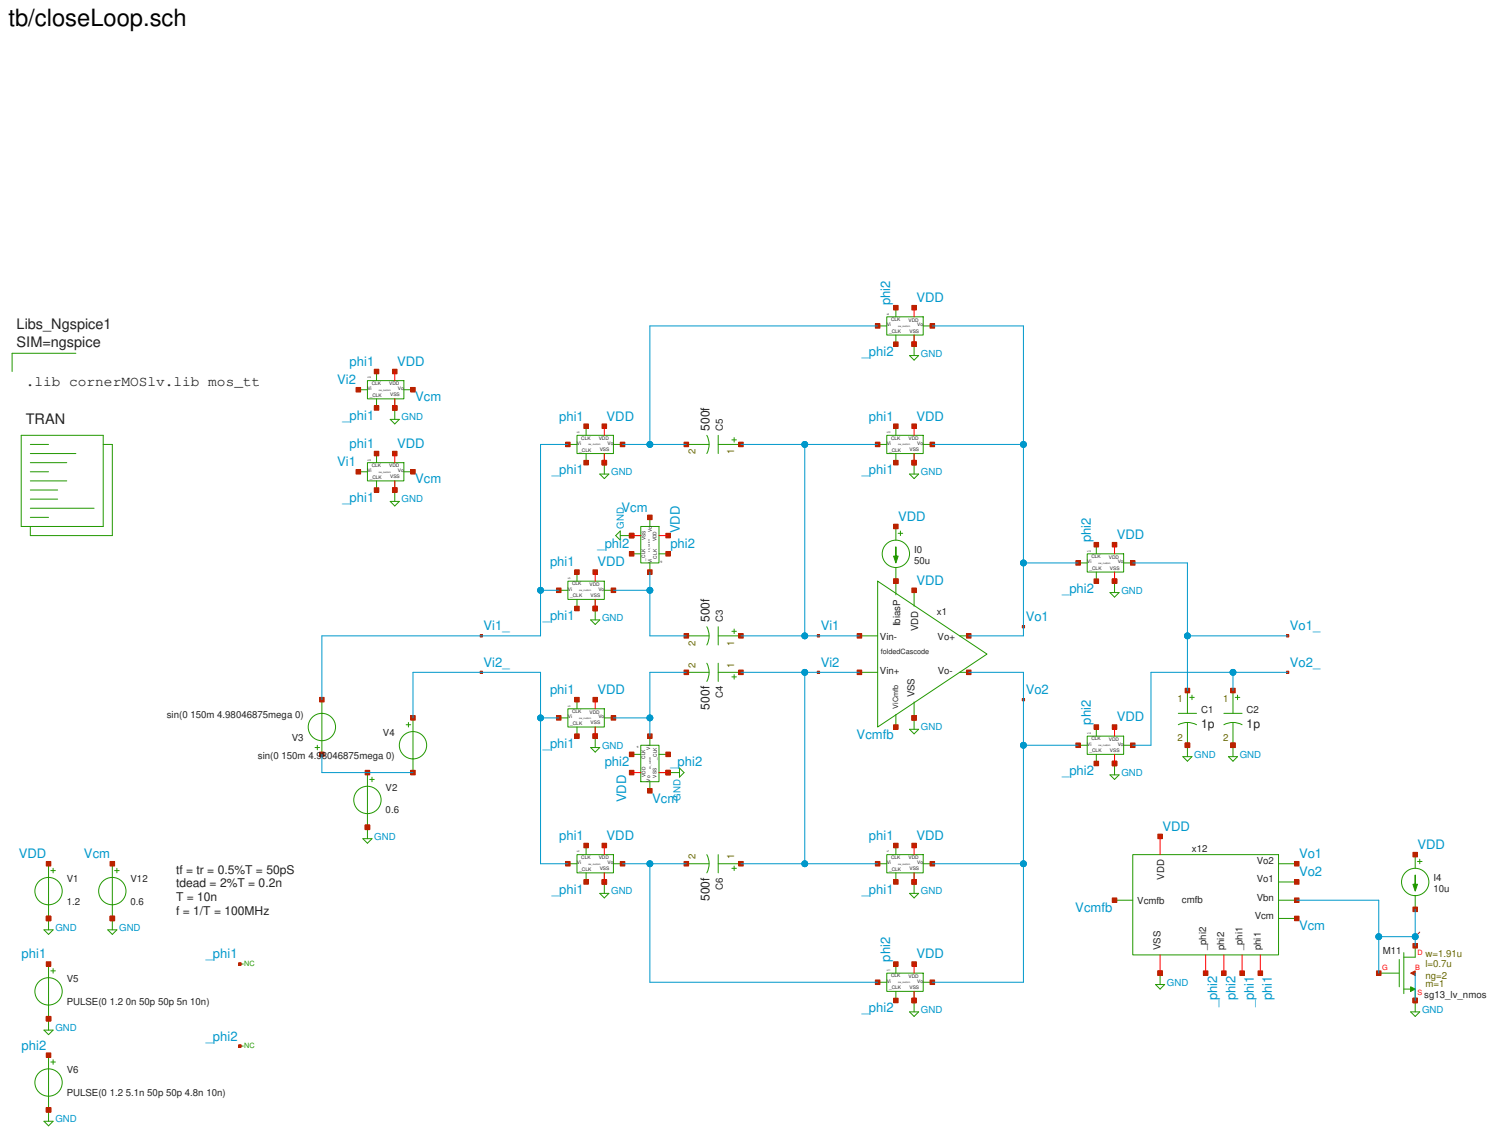
[picture p31: page 1]
foldedCascode; VDD VSS; ViCmfb IbiasP; Vin-; Vin+; GND; VDD; SIM=ngspice; PULSE(0 1.2 0n 50p 50p 5n 10n); PULSE(0 1.2 5.1n 50p 50p 4.8n 10n); phi1; phi2; sw_custom; CLK; VSS; VoVi; _CLK; _phi1; _phi2; VoVi VDD; cmfb; Vcm; Vbn Vcmfb; phi2phi2; sin(0 150m 4.98046875mega 0); sg13_lv_nmos; Vcmfb; TRAN; tf = tr = 0.5%T = 50pS tdead = 2%T = 0.2n T = 10n f = 1/T = 100MHz

.lib cornerMOSlv.lib mos_tt
