EzeG99/IHP130nm---Pipeline-ADC/report/plotsBKP/FFT_SS_VDD1.43_T125_sch.pdf

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

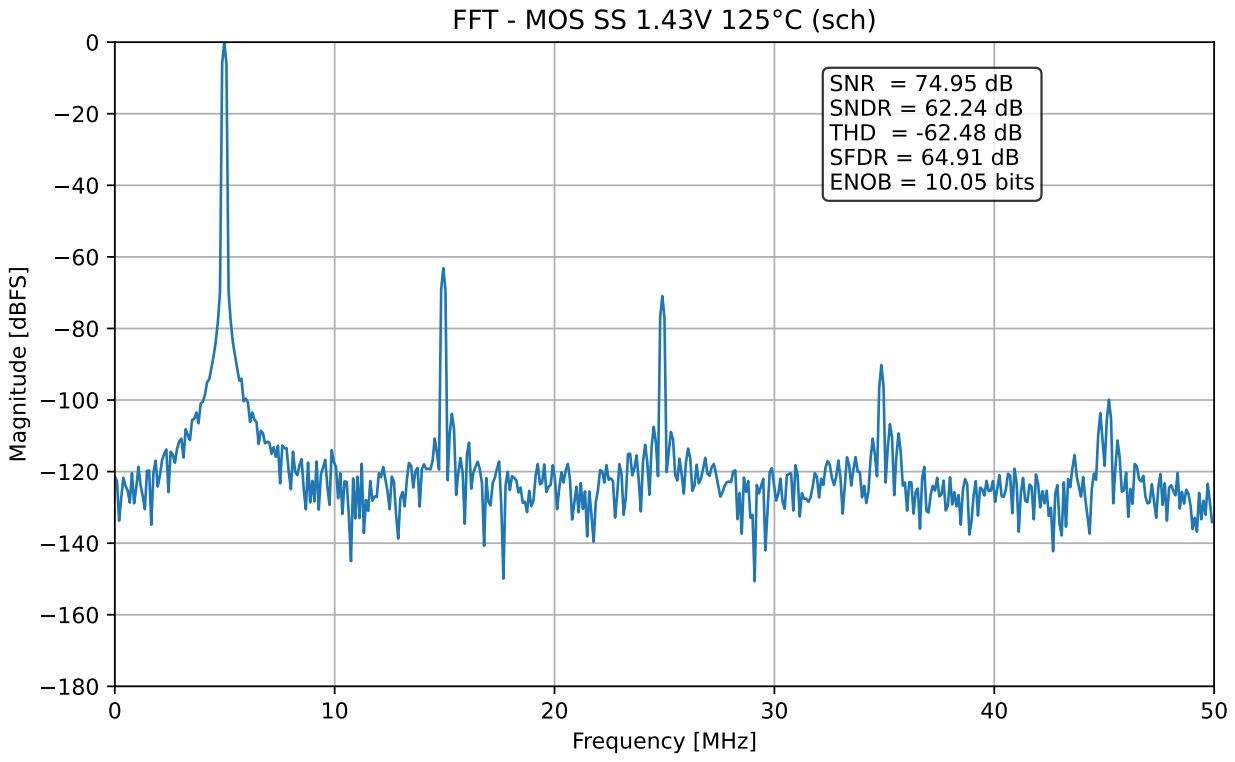
[picture p34: page 1]
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
