EzeG99/IHP130nm---Pipeline-ADC/report/plotsBKP/ICMR_combined.pdf

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

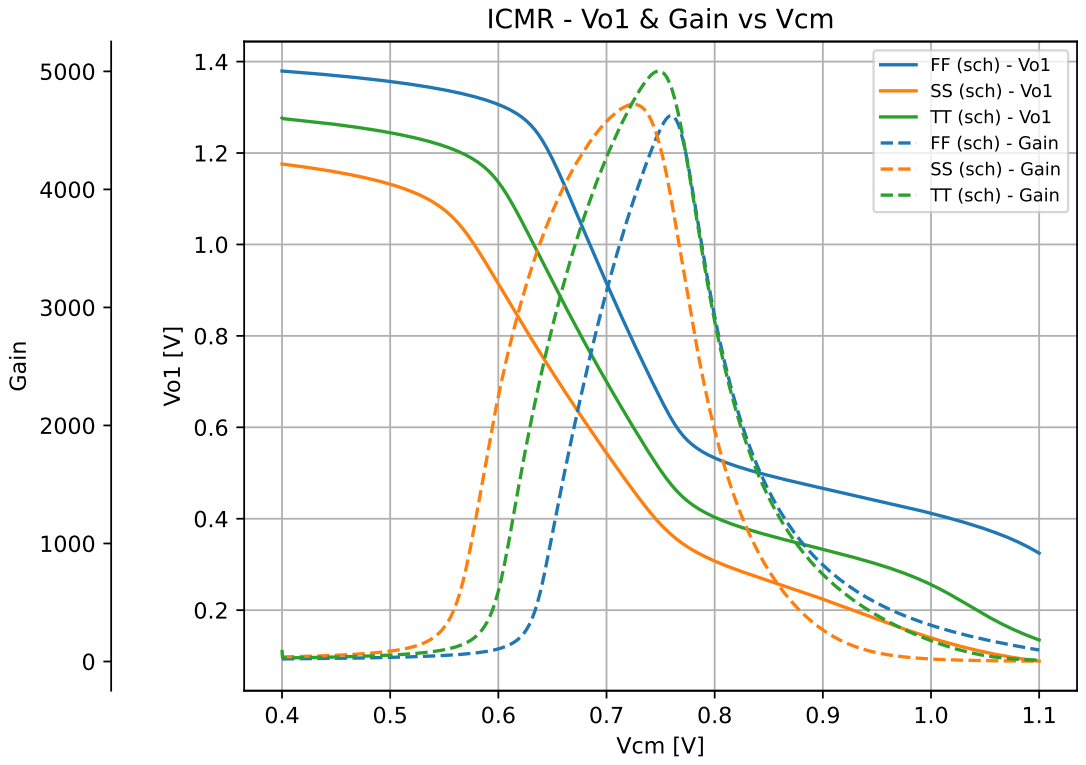
[picture p36: page 1]
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
