EzeG99/IHP130nm---Pipeline-ADC/(commit log)

2026-03-09 add bias net to testing gmBoosting
    [gmBoosting.sch]
2026-03-09 check gmBoosting in openLoop
    [gmBoosting.sch]
2026-03-10 improve bias gmBoosting across corners. Change the bias net to the one explained in Razzavis's book
    [closeLoop.sch, cmfb.sch, foldedCascode.sch, gmBoosting.sch, gmBoostingP.sch, icmr.sch, openLoop.sch, settiling.sch]
2026-03-11 aadd bias net to foldedCascode. TODO check corners and increase gain
    [foldedCascode.sch, gmBoosting.sch, openLoop.sch]
2026-03-11 Change Vb1 of GmBoosting to increase gm3 for better PM
    [gmBoosting.sch]
2026-03-12 Reduce gmBoosting Itail to decrease the BW while improving the PM and gain
    [gmBoosting.sch]
2026-03-12 Adjust W to better Vo,cm
    [gmBoosting.sch]
2026-03-12 fix make M13 equal to M0
    [gmBoosting.sch]
2026-03-12 adjust folded to better Vo,cm. Add a dc sweep for Vbn in tb OL for corners simulations
    [foldedCascode.sch, gmBoosting.sch, openLoop.sch]
2026-03-13 Change vsource (from Vbn cmfb) to a diode
    [closeLoop.sch]
2026-03-15 Increase W of M1 for higger gm1 and therefore higger gain
    [foldedCascode.sch, openLoop.sch]
2026-03-15 enob=9.28 :)
    [closeLoop.sch, cmfb.sch, openLoop.sch]
2026-03-15 fix bias in testing
    [foldedCascode.sch, gmBoosting.sch]
2026-03-15 fix bias in blocks gmBoosting
    [gmBoosting.sch]
2026-03-15 Change ideal Isource to MOS in testing folded
    [foldedCascode.sch, gmBoosting.sch]
2026-03-16 Change ideal Isource to MOS in block foldedCascode. Organize closeLoop tb
    [closeLoop.sch, cmfb.sch, foldedCascode.sch]
2026-03-16 Change icmr tb, and add mdac.json
    [icmr.sch]
2026-03-16 Change Vin to 125mVpk, change ideal sampling capacitor for the real ones
    [closeLoop.sch]
2026-03-17 Change ideal Isource fo gmBoosting to MOS
    [foldedCascode.sch, gmBoosting.sch]
2026-03-18 Fix Vov M7 pushing M9 to triode
    [cmfb.sch, foldedCascode.sch]
2026-03-18 Move Vbn diode from closeLoop to cmfb block. Add autotesbench folder setup
    [closeLoop.sch, cmfb.sch, foldedCascode.sch]
2026-03-18 icmr, and openloop autotb working. Triode M0 in SS, try to fix in testing folded cascode
    [foldedCascode.sch, icmr.sch, openLoop.sch]
2026-03-19 CHANGE TEMP CORNER, TT 65, SS 120. Reduce M0 Vov and increase W1,2 to lower Vgs and get higher VDS on M0. This increased the gain and lower the PM
    [closeLoop.sch, cmfb.sch, foldedCascode.sch, icmr.sch, openLoop.sch]
2026-03-19 Change cmfb capacitor value, add enobHF.py
    [cmfb.sch]
2026-03-20 Change cmfb capacitor, change Vin amplitude to 125m, change Ron ideal sw to a higher value, CHANGE VDD to 1.5V, better performance across corners, good PM and gain
    [HFcloseLoop.sch, cmfb.sch, icmr.sch, openLoop.sch]
2026-03-20 Change temp open loop to measure power
    [openLoop.sch]
2026-03-21 Change Cs value to adjust fine gain
    [HFcloseLoop.sch, closeLoop.sch]
2026-03-27 Changing ideal sw for CMOS ones, enob 9 bits SS
    [closeLoop.sch, cmfb.sch, sw_boost.sch, sw_tg.sch, sw_tg_big.sch]
2026-03-28 Boost sw working without ideal sw but with ideal source
    [HFcloseLoop.sch, closeLoop.sch, sw_boost.sch]
2026-03-28 Complete Boostraped SW working
    [HFcloseLoop.sch, closeLoop.sch, sw_boost.sch]
2026-03-29 Report almost complete
    [set.sch]
2026-03-31 Report complete, remove extra sw in closeloop, resize cmfb
    [HFcloseLoop.sch, closeLoop.sch, cmfb.sch, icmr.sch, openLoop.sch, sw_tg_big.sch]
2026-04-14 Report final version
    [closeLoop.sch]
